p-prieto-vidal/Erigami-foldable-printed-electronics/sample-library/erigami_sample_library.pdf

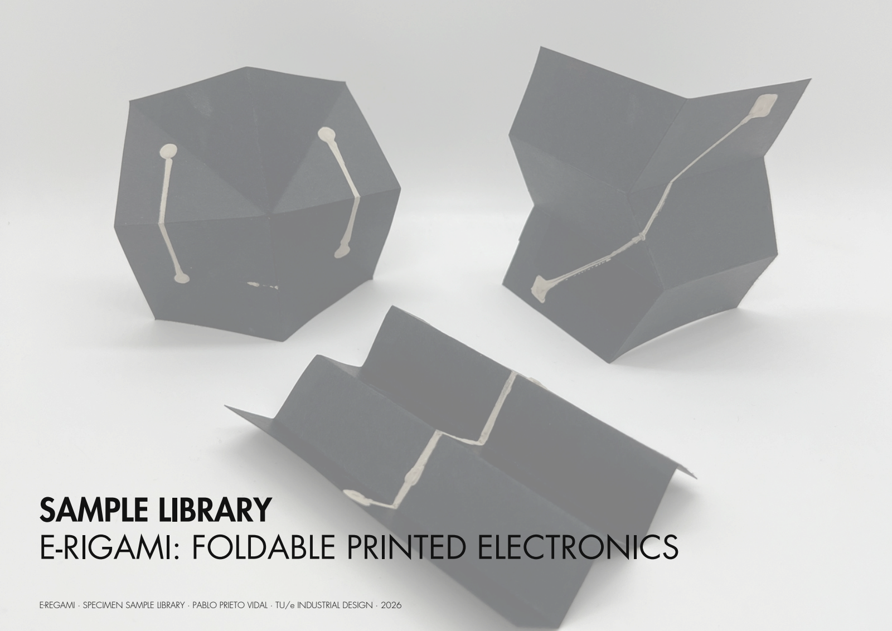
[picture p1: page 1]

# SAMPLE LIBRARY

E-REGAMI · SPECIMEN SAMPLE LIBRARY · PABLO PRIETO VIDAL · TU/e INDUSTRIAL DESIGN · 2026

# E-RIGAMI: FOLDABLE PRINTED ELECTRONICS

# MO_45_UNCUT

### Miura-Ori Sample

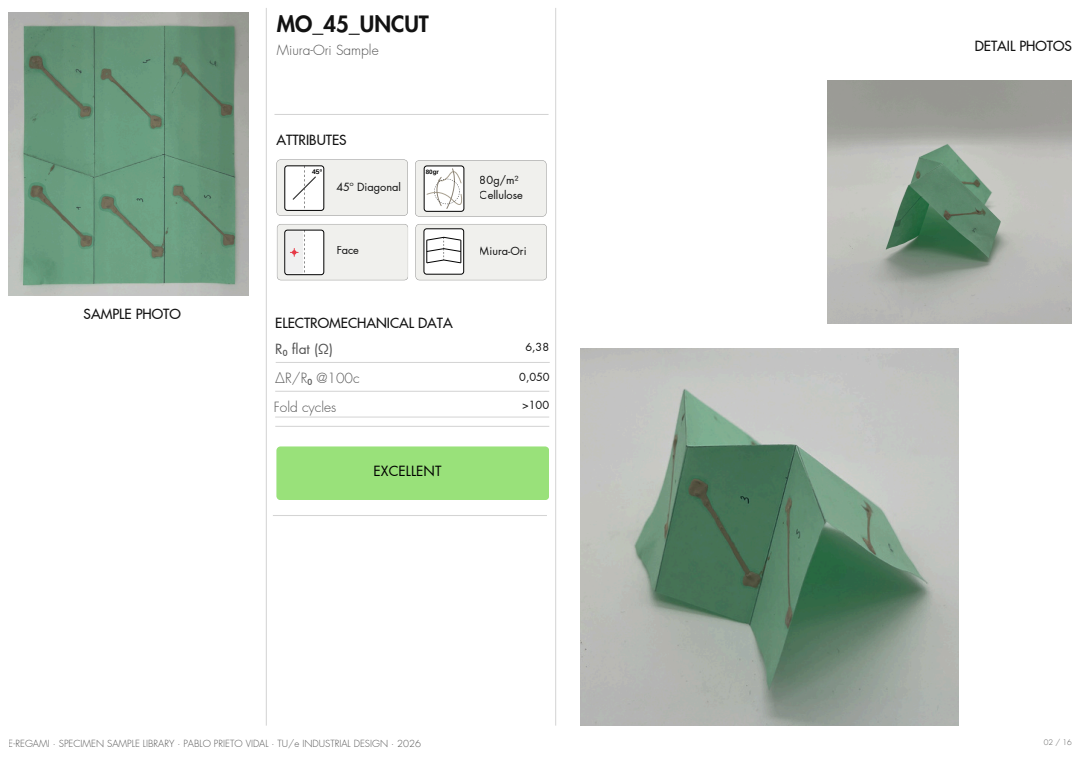
[picture p2: page 2]
45º Diagonal; EXCELLENT; ATTRIBUTES; ELECTROMECHANICAL DATA; DETAIL PHOTOS; R₀ flat (Ω); Fold cycles; Face; 80g/m² Cellulose; Miura-Ori; SAMPLE PHOTO

# MO_45_CUT

### Miura-Ori Sample

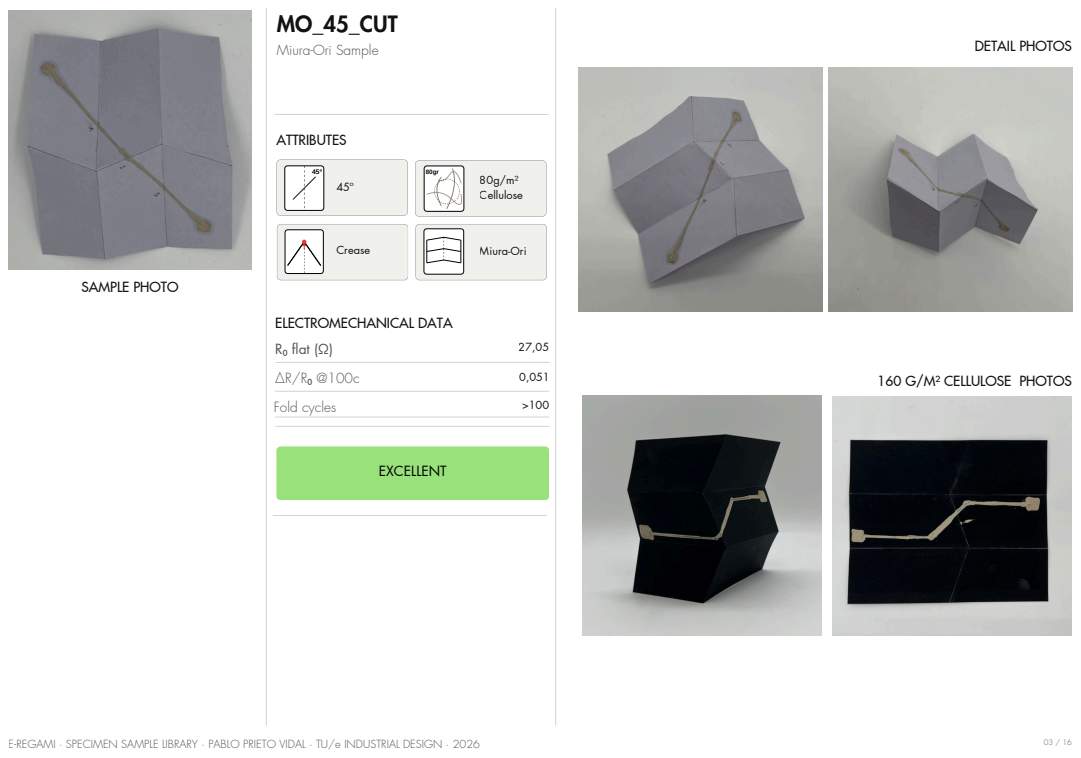
[picture p3: page 3]
EXCELLENT; ATTRIBUTES; ELECTROMECHANICAL DATA; DETAIL PHOTOS; R₀ flat (Ω); Fold cycles; Crease; 80g/m² Cellulose; Miura-Ori; SAMPLE PHOTO

160 G/M² CELLULOSE PHOTOS

# MO_0_UNCUT

### Miura-Ori Sample

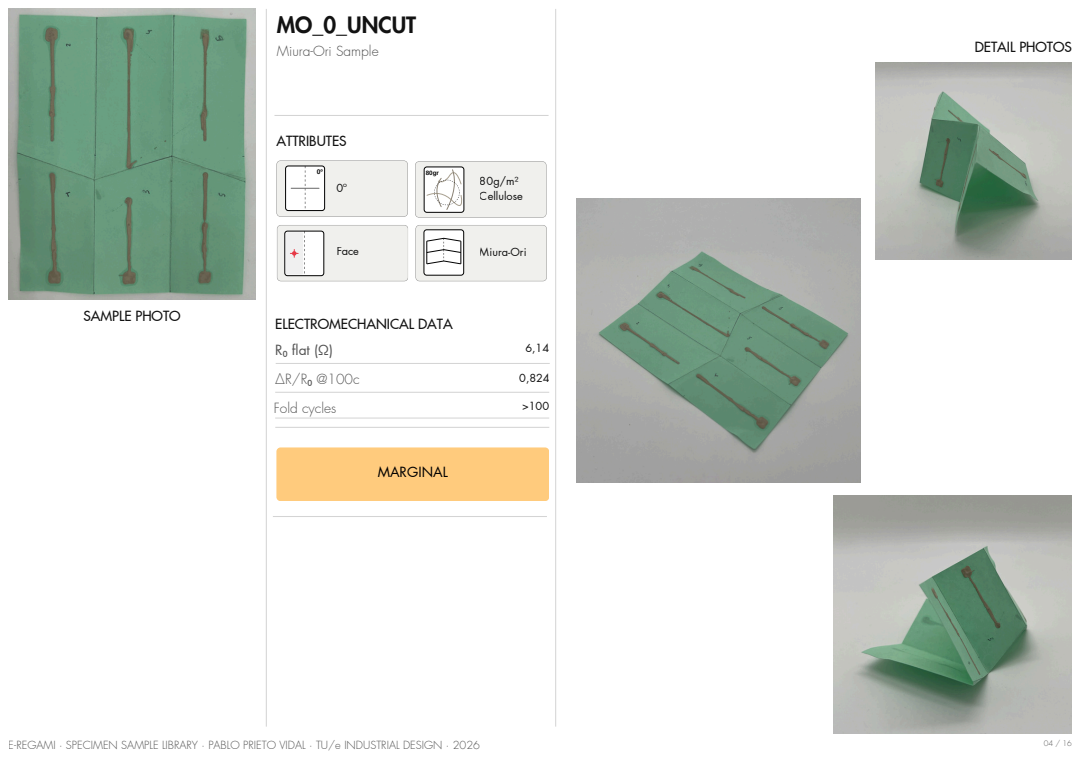
[picture p4: page 4]
MARGINAL; ATTRIBUTES; ELECTROMECHANICAL DATA; DETAIL PHOTOS; R₀ flat (Ω); Fold cycles; Face; 80g/m² Cellulose; Miura-Ori; SAMPLE PHOTO

# MO_90_UNCUT

### Miura-Ori Sample

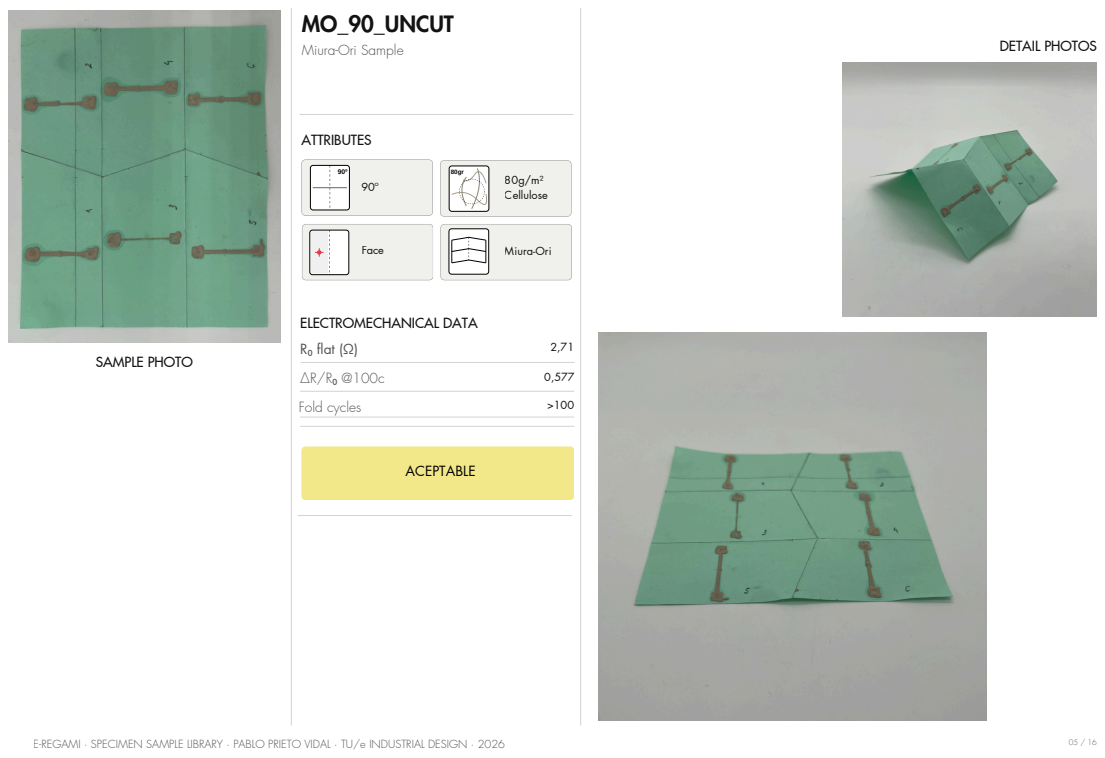
[picture p5: page 5]
ACEPTABLE; ATTRIBUTES; ELECTROMECHANICAL DATA; DETAIL PHOTOS; R₀ flat (Ω); Fold cycles; Face; 80g/m² Cellulose; Miura-Ori; SAMPLE PHOTO

# KR_0_5

### Kirigami Sample

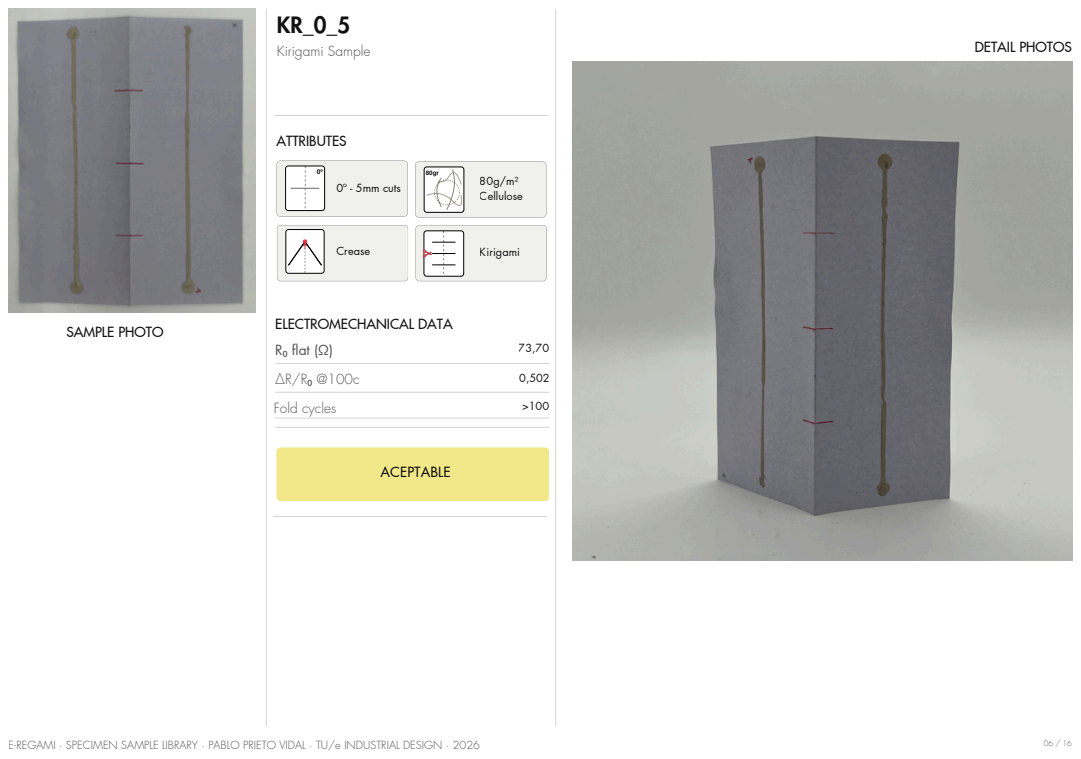
[picture p6: page 6]
0º - 5mm cuts; ACEPTABLE; ATTRIBUTES; ELECTROMECHANICAL DATA; DETAIL PHOTOS; R₀ flat (Ω); Fold cycles; Crease; 80g/m² Cellulose; Kirigami; SAMPLE PHOTO

# KR_0_10_L1 & L2

### Kirigami Sample

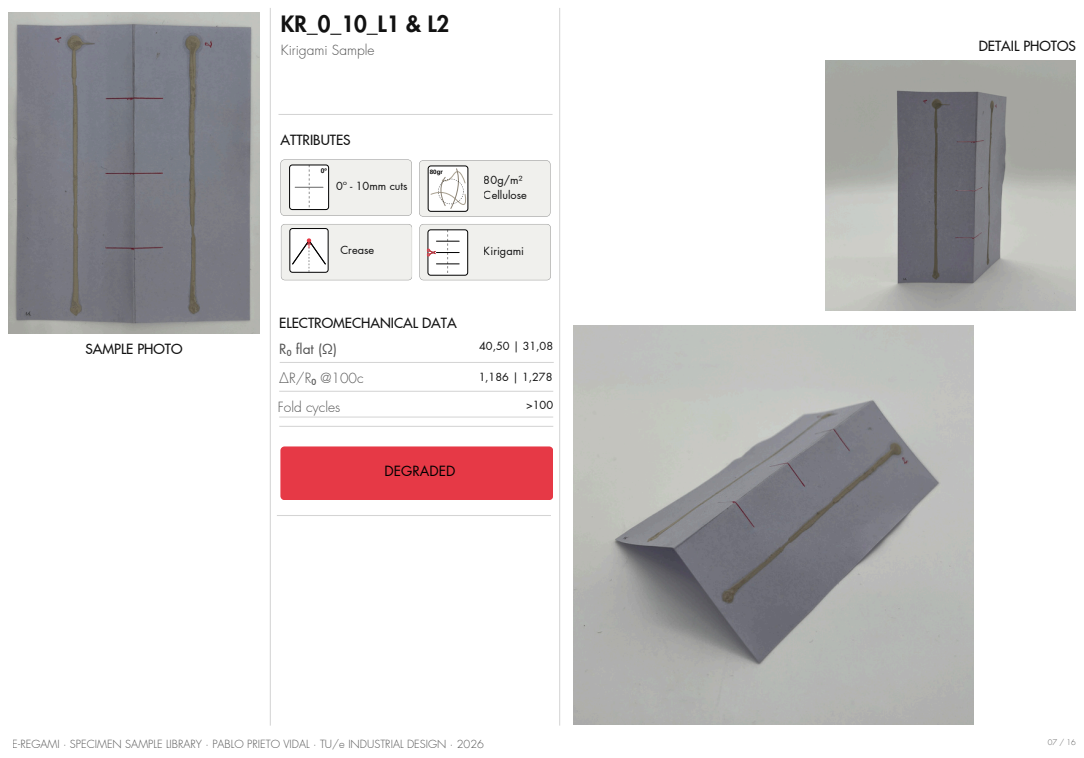
[picture p7: page 7]
0º - 10mm cuts; DEGRADED; ATTRIBUTES; ELECTROMECHANICAL DATA; DETAIL PHOTOS; R₀ flat (Ω); Fold cycles; Crease; 80g/m² Cellulose; Kirigami; SAMPLE PHOTO

# KR_TWISTING

### Kirigami Sample

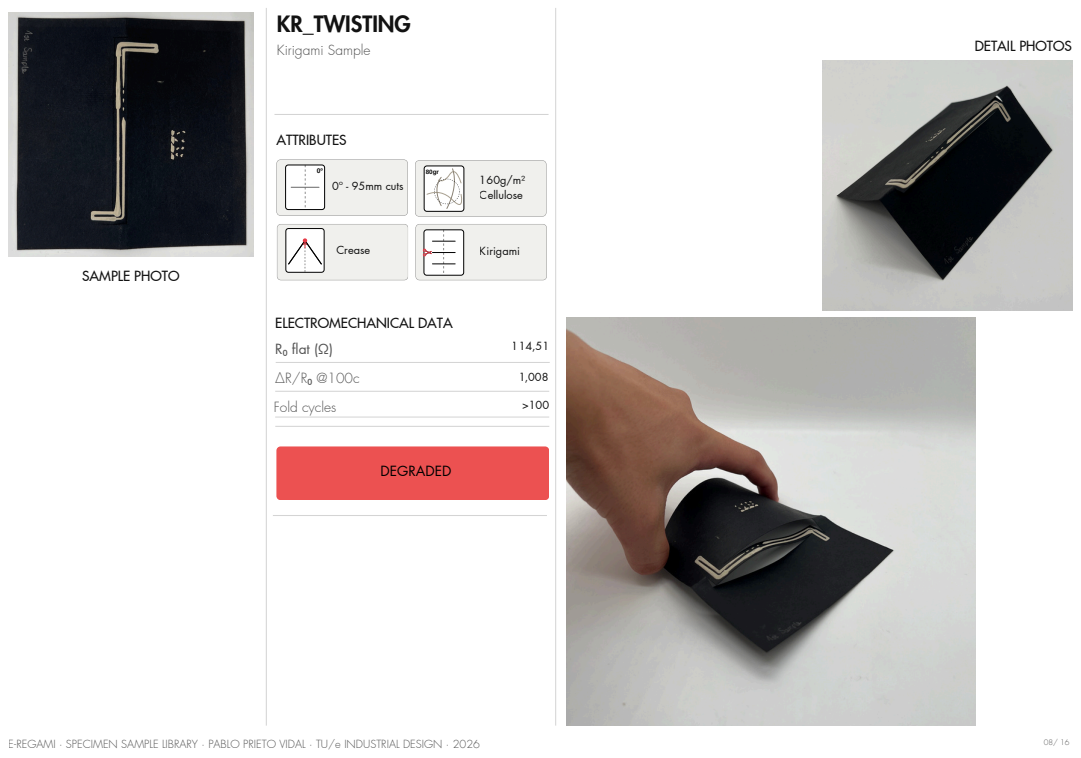
[picture p8: page 8]
0º - 95mm cuts; DEGRADED; ATTRIBUTES; ELECTROMECHANICAL DATA; DETAIL PHOTOS; R₀ flat (Ω); Fold cycles; Crease; 160g/m² Cellulose; Kirigami; SAMPLE PHOTO

# KR_90_BRIDGE_L1 & L2

### Kirigami Sample

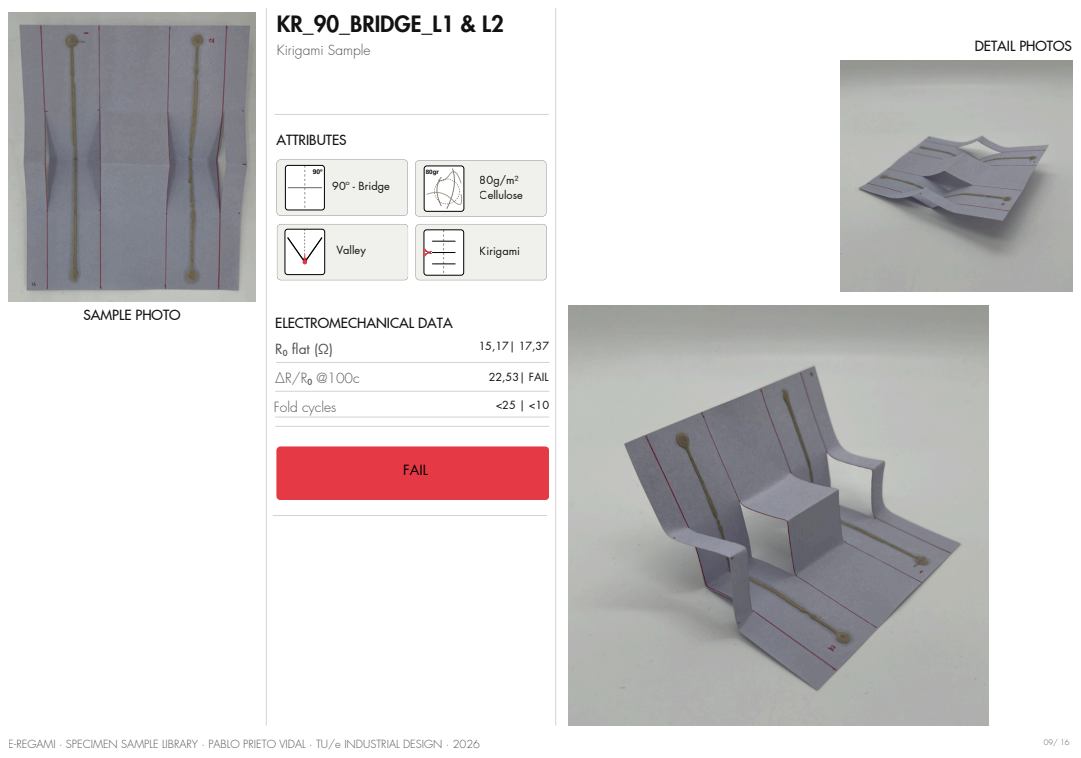
[picture p9: page 9]
90º - Bridge; FAIL; ATTRIBUTES; ELECTROMECHANICAL DATA; DETAIL PHOTOS; R₀ flat (Ω); Fold cycles; 22,53| FAIL; Valley; 80g/m² Cellulose; Kirigami; SAMPLE PHOTO

# SC_90_L1 & L2

### Single Crease Sample

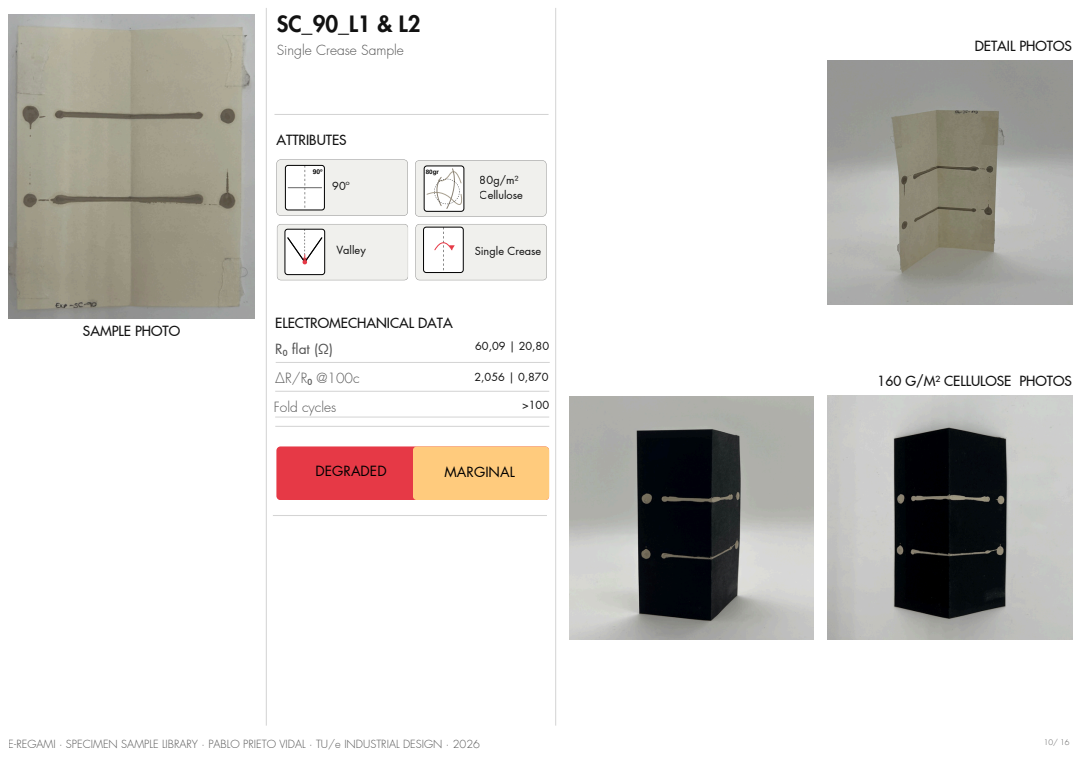
[picture p10: page 10]
DEGRADED; ATTRIBUTES; ELECTROMECHANICAL DATA; DETAIL PHOTOS; R₀ flat (Ω); Fold cycles; Valley; 80g/m² Cellulose; Single Crease; SAMPLE PHOTO; MARGINAL

160 G/M² CELLULOSE PHOTOS

# SC_0_L1 & L2

### Single Crease Sample

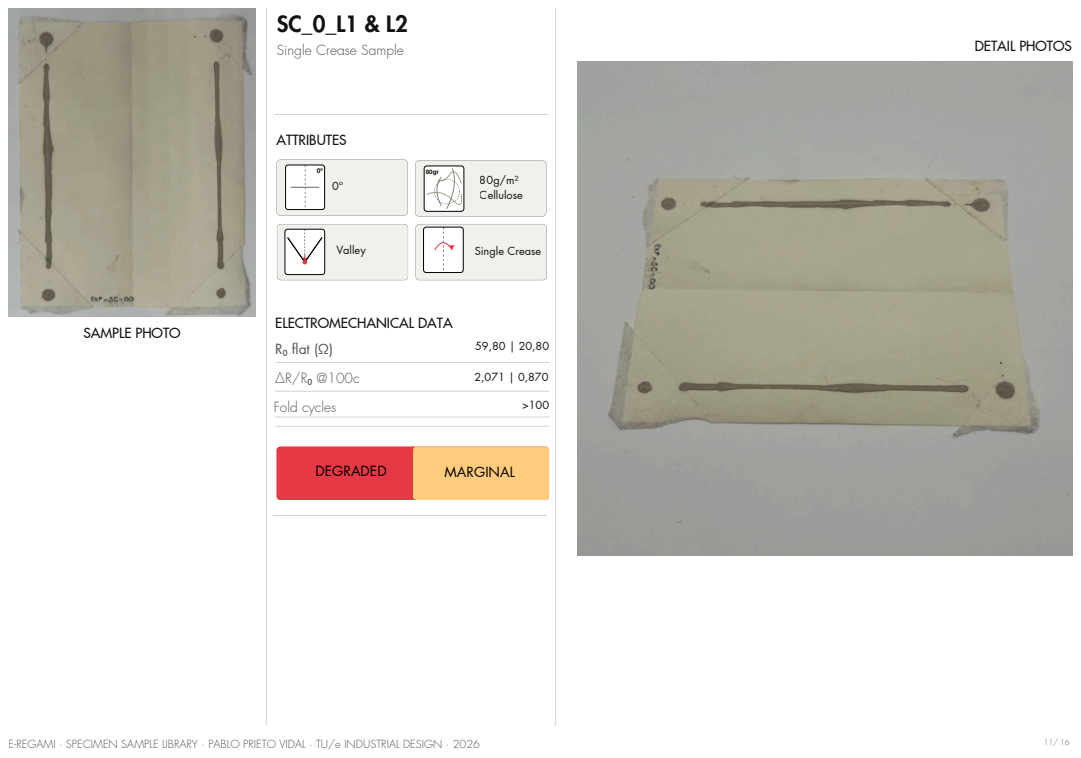
[picture p11: page 11]
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

# SC_45

### Single Crease Sample

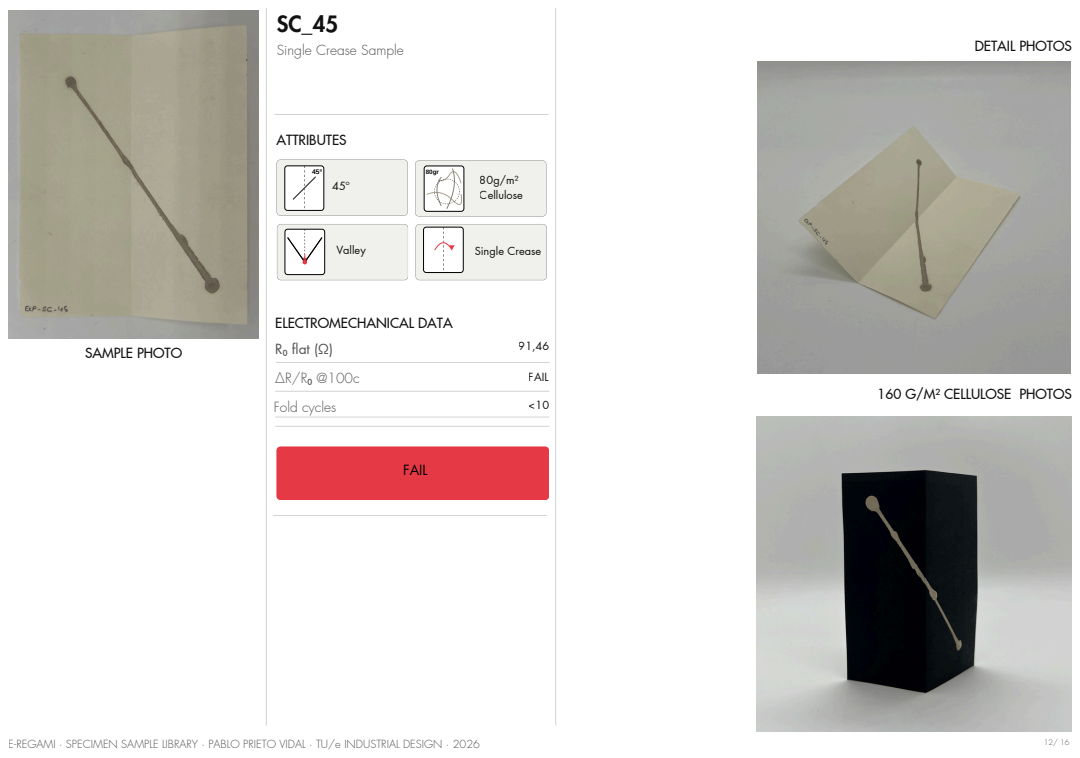
[picture p12: page 12]
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

160 G/M² CELLULOSE PHOTOS

# ACC_90_L1 & L2

### Accordion Sample

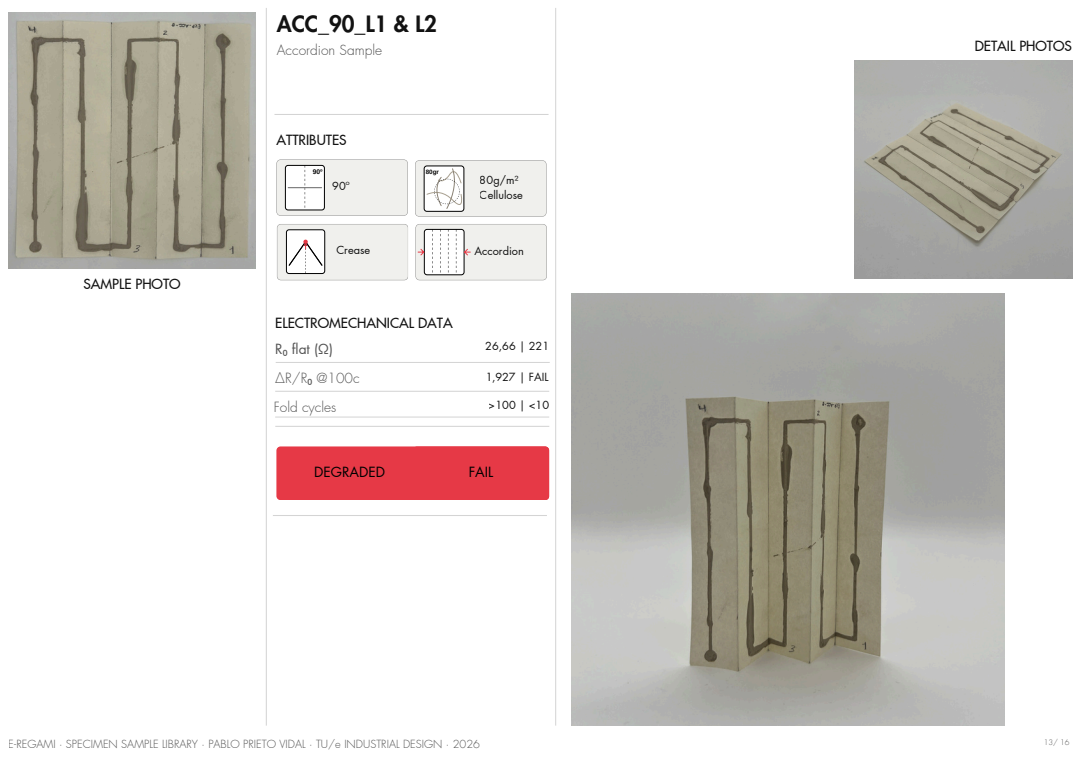
[picture p13: page 13]
DEGRADED; ATTRIBUTES; ELECTROMECHANICAL DATA; DETAIL PHOTOS; R₀ flat (Ω); Fold cycles; 1,927 | FAIL; Crease; 80g/m² Cellulose; Accordion; SAMPLE PHOTO; FAIL

# ACC_45_L1

### Accordion Sample

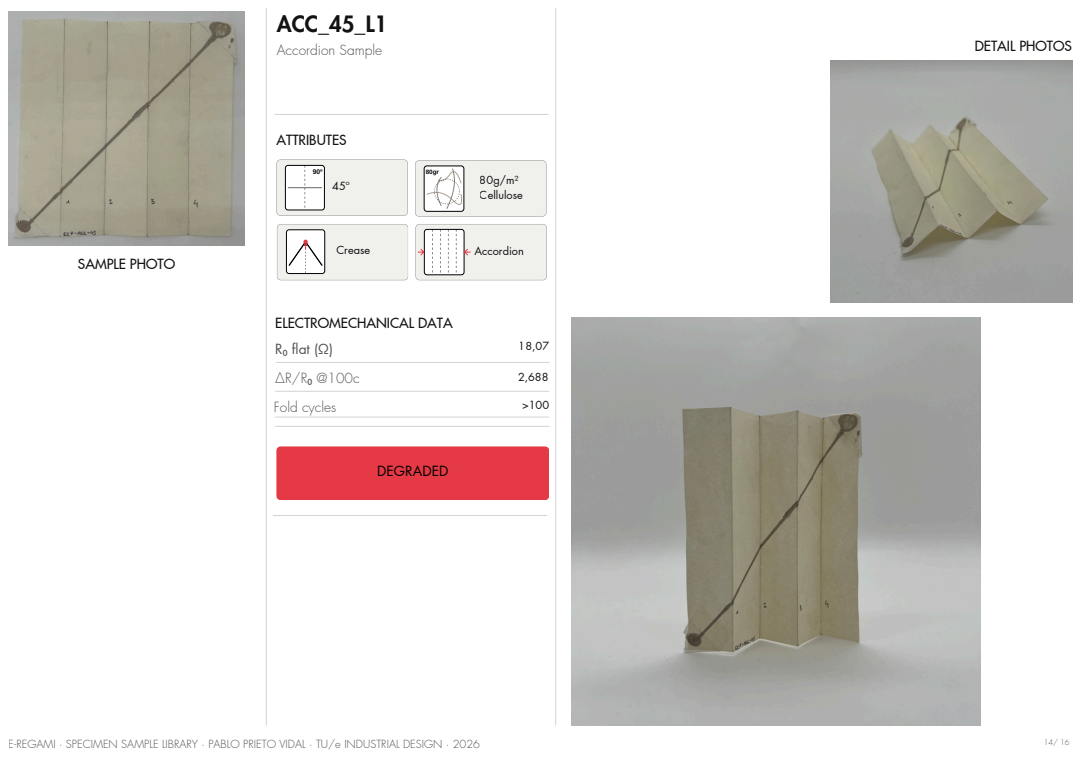
[picture p14: page 14]
DEGRADED; ATTRIBUTES; ELECTROMECHANICAL DATA; DETAIL PHOTOS; R₀ flat (Ω); Fold cycles; Crease; 80g/m² Cellulose; Accordion; SAMPLE PHOTO

# ACC_0_L1 & L4

### Accordion Sample

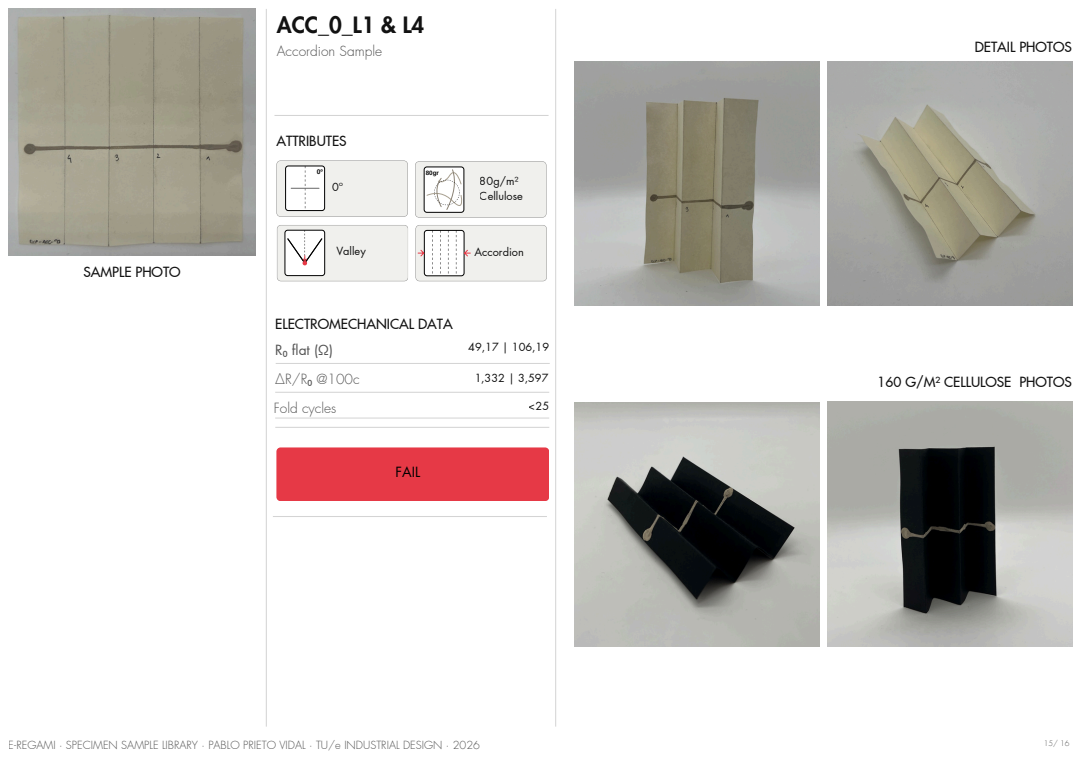
[picture p15: page 15]
FAIL; ATTRIBUTES; ELECTROMECHANICAL DATA; DETAIL PHOTOS; R₀ flat (Ω); Fold cycles; Valley; 80g/m² Cellulose; Accordion; SAMPLE PHOTO

160 G/M² CELLULOSE PHOTOS

# WB_VALLEY

### Water Bomb Sample

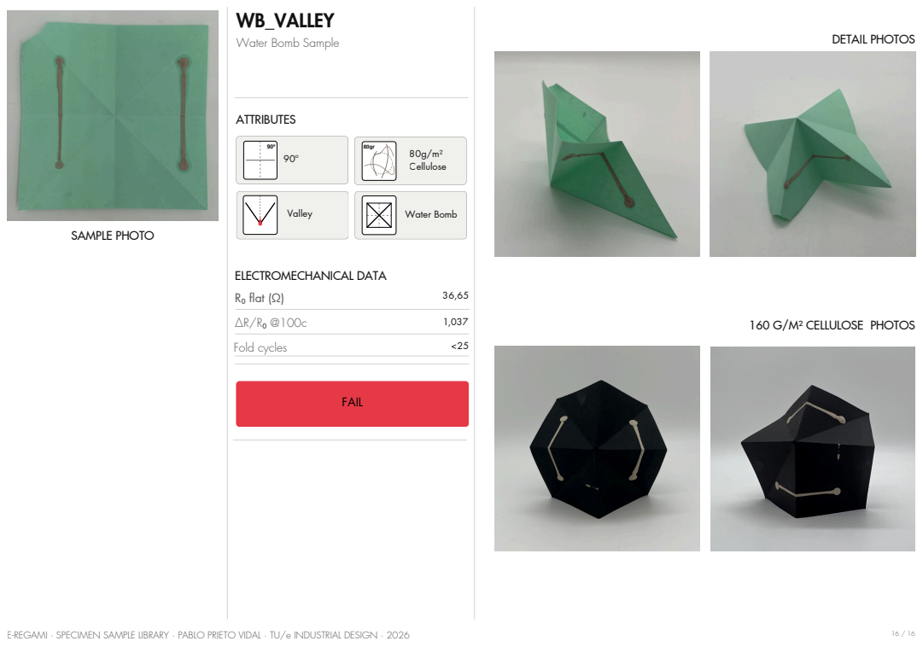
[picture p16: page 16]
FAIL; ATTRIBUTES; ELECTROMECHANICAL DATA; DETAIL PHOTOS; R₀ flat (Ω); Fold cycles; Valley; 80g/m² Cellulose; Water Bomb; SAMPLE PHOTO

160 G/M² CELLULOSE PHOTOS
